ryanmillerwork/juicer/firmware.md

# Firmware build/upload notes

# using github actions:

# automatically compiles on pushes. to make sure the release is stored, tag it:

git tag v3.0.0

git push origin v3.0.0

# to pull the last tagged version

gh release list

gh release download v3.0.0 -p "*.bin"

OR

wget https://github.com/ryanmillerwork/juicer/releases/download/v3.0.0/juice_pump3.ino.bin

# to pull the latest 

gh run list

gh run download RUN_ID --name compiled-binary

compile on hb-server

# get juicer code

cd ~/bin

git clone https://github.com/ryanmillerwork/juicer.git

cd juicer

# if using esp32-s3 reverse tft:

sudo nano ~/.arduino15/packages/esp32/hardware/esp32/3.1.1/variants/adafruit_feather_esp32s3_reversetft/pins_arduino.h

change to "#define USB_PRODUCT "juicer3"

# compile

~/bin/arduino-cli compile --fqbn esp32:esp32:adafruit_feather_esp32s3_reversetft --build-path ~/bin/juicer/juice_pump3/build ~/bin/juicer/juice_pump3/

or

~/bin/arduino-cli compile --fqbn esp32:esp32:adafruit_feather_esp32s2_reversetft_juicer --build-path ~/bin/juicer/juice_pump3/build ~/bin/juicer/juice_pump3

## Troubleshooting build failures

If `arduino-cli compile` fails with:

`Failed to extract libcrypto.so.1.1: decompression resulted in return code -1!`

This is almost always either **(1) disk space / inode exhaustion** (often in `/tmp`) or **(2) a corrupted Arduino cache / staged download**.

1) Check disk space + inodes:

```bash
df -h /tmp ~
df -i /tmp ~
```

2) If space is tight in `/tmp`, point temp elsewhere:

```bash
export TMPDIR="$HOME/tmp"
mkdir -p "$TMPDIR"
```

3) Clear caches and reinstall the ESP32 core/tools:

```bash
rm -rf ~/.arduino15/staging ~/.arduino15/cache
~/bin/arduino-cli core update-index
~/bin/arduino-cli core uninstall esp32:esp32
~/bin/arduino-cli core install esp32:esp32@3.1.1
```

# upload from hb-server to ESP32-s3
```bash
ls /dev/ttyUSB* /dev/ttyACM* 2>/dev/null

~/bin/arduino-cli upload \
  --fqbn esp32:esp32:adafruit_feather_esp32s3_reversetft \
  --port /dev/ttyACM0 \
  --input-dir ~/bin/juicer/juice_pump3/build

or

~/bin/arduino-cli upload   --fqbn esp32:esp32:adafruit_feather_esp32s2_reversetft_juicer   --port /dev/ttyACM0   --input-dir ~/bin/juicer/juice_pump3/build
```

# push back

git add juice_pump3/build/

git commit -m "Add compiled ESP32 firmware build"

git push origin main

# on homebase
# initial setup

cd ~/code

sudo usermod -a -G dialout lab

sudo curl -fsSL https://raw.githubusercontent.com/arduino/arduino-cli/master/install.sh | sh

~/code/bin/arduino-cli core install esp32:esp32

git clone https://github.com/ryanmillerwork/juicer.git

# just to upload code

unplug/replug usb to microcontroller

cd ~/code/juicer/juice_pump3

~/code/bin/arduino-cli board list 

~/code/bin/arduino-cli upload --fqbn esp32:esp32:adafruit_feather_esp32s3_reversetft -p /dev/ttyACM0 --input-dir ./build/ .

sudo systemctl restart dserv

# calibrating

put exactly 500 ml in container

screen /dev/ttyACM0 115200

{"do": {"calibration": {"n": 600, "on": 500, "off": 500}}}

(wait 10 minutes, measure amount of fluid dispensed [f])

if f=200, ml/s = 200/(600*0.5) = 0.67 ml/s

{"set": {"flow_rate": 0.67}}

~3 months after calibration, testing accuracy and precision of 15 individual 1 mL dispersements:

range: 0.94 -- 1.00

mean: 0.97

median: 0.97

STD: 0.02

# setting purge volume

screen /dev/ttyACM0 115200

{"get": ["purge_vol"]}

{"set": {"purge_vol": 20}}
