ryanmillerwork/juicer/20250921_110635.jpg

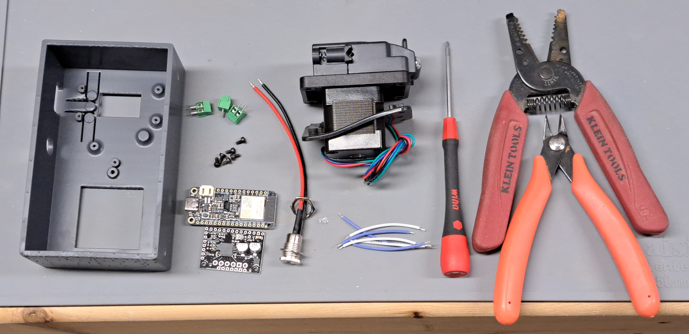
20250921_110635.jpg
