ryanmillerwork/juicer/20250921_114202.jpg

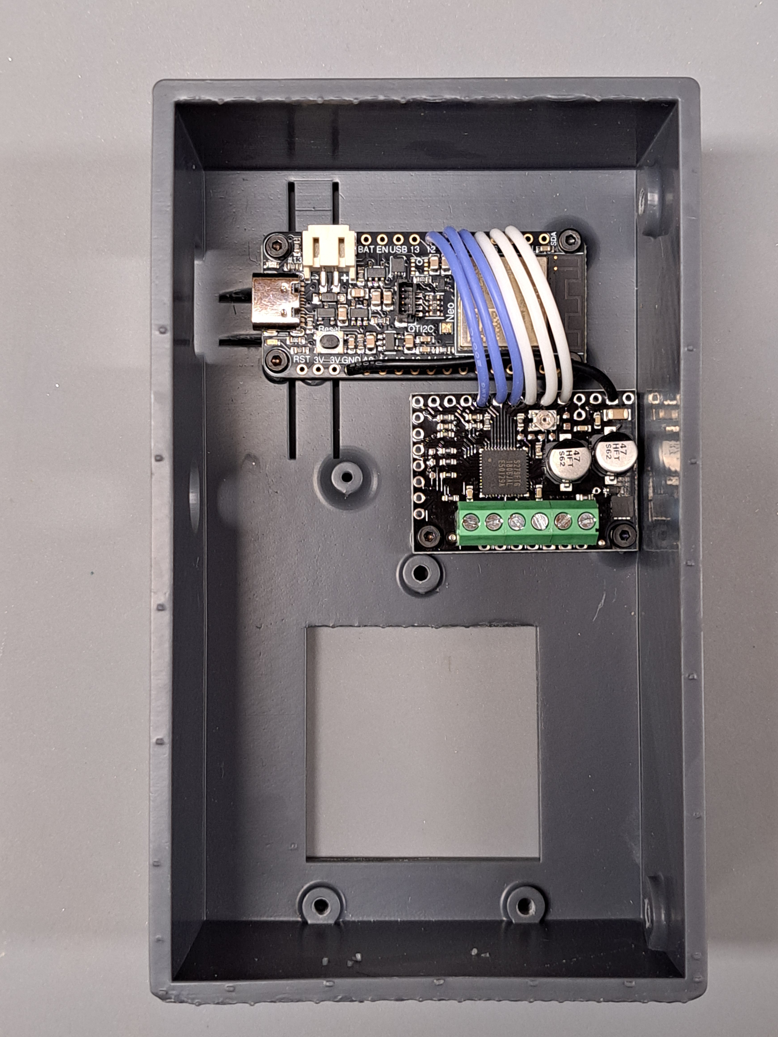
20250921_114202.jpg
