ryanmillerwork/juicer/juice_pump3/juice_pump3.ino

#include <Arduino.h>
#include <driver/ledc.h>
#include <SPI.h>   
#include <Preferences.h>         
#include <Adafruit_GFX.h>         // 1.12.0 by Adafruit
#include <Fonts/FreeMono9pt7b.h>  // from Adafruit_GFX
#include <Adafruit_ST7789.h>      // 1.10.4 by Adafruit
#include <Adafruit_NeoPixel.h>    // 1.12.5 by Adafruit
#include <ArduinoJson.h>          // 7.2.0 by Benoit Blanchon


// Define constants
const int PULSES_PER_STEP = 32;
const int STEPS_PER_REV = 200;
const int MAX_RPS = 8;
const int MAX_PWM_FREQ_MOTOR = PULSES_PER_STEP * STEPS_PER_REV * MAX_RPS;
// Juice level sensor input.
// NOTE: GPIO4 is also the board's built-in I2C SCL pin (STEMMA QT header). If you use it for juice level,
// you should not use the built-in I2C header at the same time.
const int JUICE_LEVEL_LOW_PIN = 4;   // GPIO4 / SCL (LOW = water detected)

float flow_rate;                  // This is the empirically determined flow rate given the target_rps, stored in flash
float purge_vol;                  // Volume to purge when pressing the purge button, stored in flash
int reward_number = 0;            // Number of rewards since being reset
float reward_mls = 0.0;           // Volume of rewards since being reset 
bool purging = false;             // Goes true while purging
bool manual_watering = false;     // Goes true while pressing water button
bool ttl_watering = false;        // Goes true while TTL input line is high
bool serial_watering = false;     // Goes true while watering requested by serial port
bool calibration_in_progress = false;
int calibration_n = 0;
int calibration_on = 0;
int calibration_off = 0;
int calibration_count = 0;
unsigned long calibration_start_time = 0;
float serial_vol = 0.0;           // Keep track of this in case it needs to be subtracted for overlapping rewards
float target_rps;                 // Target rotations per second of the pump head. max is around 3-4
int target_hz;                    // Frequency of pulses to achieve desired target_rps
bool reset_pressed = false;       // Keeps track of button press to only execute on button down
unsigned long water_start_time = 0; // Keeps track of when you first press manual start so we can track amount given
unsigned long ttl_start_time = 0;   // Keeps track of when TTL watering starts so dispensed volume can be calculated on stop
bool pump_running = false;        // Keeps track of if pump is running
uint32_t pump_stop_time = 0;      // What time to stop the pump
bool sched_disp_update = false;   // For when you want to update the display but not quite yet
bool serialConnected = false;
bool notify_reward_complete_pending = false;

// What to do if a serial reward arrives while a serial reward is already in progress.
// - replace: stop/shorten current reward and start requested
// - append: extend current reward by requested amount
// - reject: reject new reward while reward is running
enum RewardOverlapPolicy { ROP_REPLACE = 0, ROP_APPEND = 1, ROP_REJECT = 2 };
RewardOverlapPolicy reward_overlap_policy = ROP_REPLACE;

// Digital juice level monitoring variables
String juice_level = "<50mLs";  // Current juice level status
unsigned long last_juice_check_time = 0;  // For 5-second checks

const int pwmChannel = 0;
const int pwmResolution = 8; // 8-bit resolution
// int stepChannel = -1; // global variable to hold the LEDC channel for the STEP_PIN

const int LEDC_CHANNEL = 0;  // LEDC channel (0-7 for ESP32-S2)
const int LEDC_TIMER_BIT = 8; // 8-bit timer resolution
const int LEDC_BASE_FREQ = 100000; // Base frequency in Hz
const int LEDC_RESOLUTION = 8; // 8-bit resolution
const int stepChannel = 0;  // Use a valid LEDC channel (0-7 for ESP32-S2)
const uint8_t ledcChannel = 0;  // Using channel 0




// Display, NeoPixel, flash setup
Adafruit_ST7789 tft = Adafruit_ST7789(TFT_CS, TFT_DC, TFT_RST);
Adafruit_NeoPixel pixels = Adafruit_NeoPixel(1, PIN_NEOPIXEL, NEO_GRB + NEO_KHZ800);
Preferences preferences;

// test with screen /dev/ttyACM0

/*
 * Available API Commands:
 *
 * 1. Set Commands:
 *    - {"set": {"flow_rate": <float>}}
 *      - Sets the flow rate (must be > 0).
 *    - {"set": {"adjust_flow_rate": {"expected_mls": <float>, "actual_mls": <float>}}}
 *      - Adjusts the stored flow rate using a measured dispense:
 *        - flow_rate_new = flow_rate_old * (actual_mls / expected_mls)
 *        - Returns extra fields: flow_rate_old, flow_rate_new, scale_factor
 *      - NOTE: You must use either set.flow_rate OR set.adjust_flow_rate (not both).
 *    - {"set": {"purge_vol": <float>}}
 *      - Sets the purge volume (must be > 0).
 *    - {"set": {"target_rps": <float>}} {"set": {"target_rps": 3}}
 *      - Sets the target revolutions per second (must be > 0 and <= MAX_RPS).
 *    - {"set": {"direction": "<left|right>"}}  {"set": {"direction": "right"}}
 *      - Persists the pump direction (default is "left", meaning pump from right to left) for all future pump actions.
 *    - {"set": {"reward_overlap_policy": "<replace|append|reject>"}}
 *      - Controls what happens if a reward arrives while a serial reward is already running:
 *        - replace: preempt current and start requested (default)
 *        - append: extend current reward by requested amount
 *        - reject: ignore new reward while reward is running
 *
 * 2. Do Commands (only 1 allowed per request):
 *    - {"do": "abort"}
 *      - Aborts the current operation, stops the pump, and updates reward metrics.
 *    - {"do": "reset"}
 *      - Resets reward counters (number and mLs), same as pressing the reset hardware button.
 *    - {"do": {"reward": <float>}} {"do": {"reward": 0.8}}
 *      - Dispenses a reward of the specified amount (must be > 0).
 *      - If pump is busy (purge/manual/calibration), reward is rejected.
 *      - If a serial reward is running, behavior depends on reward_overlap_policy.
 *    - {"do": {"purge": <float>}}
 *      - Starts a purge operation for the specified amount (must be > 0).
 *    - {"do": {"calibration": {"n": <int>, "on": <int>, "off": <int>}}} {"do": {"calibration": {"n": 10, "on": 500, "off": 500}}}
 *      - Runs a calibration cycle with:
 *        - n: Number of cycles (must be > 0).
 *        - on: Duration in milliseconds for the pump to be ON (must be > 0).
 *        - off: Duration in milliseconds for the pump to be OFF (must be > 0).
 *
 * 3. Get Commands:
 *    - {"get": ["flow_rate"]}
 *      - Retrieves the current flow rate.
 *    - {"get": ["purge_vol"]}
 *      - Retrieves the current purge volume.
 *    - {"get": ["target_rps"]}
 *      - Retrieves the current target revolutions per second.
 *    - {"get": ["reward_mls"]}
 *      - Retrieves the total amount of reward dispensed in milliliters.
 *    - {"get": ["reward_number"]}
 *      - Retrieves the total number of rewards dispensed.
 *    - {"get": ["direction"]}
 *      - Retrieves the persisted pump direction ("left" or "right")
 *    - {"get": ["reward_overlap_policy"]}
 *      - Retrieves the reward overlap policy ("replace", "append", or "reject")
 *    - {"get": ["pump_state"]}
 *      - Retrieves a minimal pump state string: "idle", "purge", "manual", "serial_reward", "ttl", or "calibration"
 *    - {"get": ["juice_level"]}
 *      - Retrieves juice level status string: ">50mLs" or "<50mLs" from the single low-level sensor on GPIO4
 *    - {"get": ["<unknown_parameter>"]}
 *      - Returns "Unknown parameter" for any unrecognized parameter.
 *
 * Example Combined Request:
 *    {"set": {"target_rps": 2, "flow_rate": 0.65}, "do": {"reward": 1},"get": ["reward_mls", "reward_number"]}
 *
 * Expected Response:
 *    {
 *      "status": "success",
 *      "reward_mls": <float>,
 *      "reward_number": <int>
 *    }
 */


// Pin definitions for motor and switches
#define DMODE0_PIN 5
#define DMODE1_PIN 6
#define DMODE2_PIN 9
#define DIR_PIN 10
#define STEP_PIN 11
#define EN_PIN 12

#define SWITCH_D0_PIN 0  // D0 is also used as the BOOT button, pulled HIGH by default
#define SWITCH_D1_PIN 1
#define SWITCH_D2_PIN 2
#define TTL_WATER_PIN 13


enum PumpDirection { DIR_LEFT, DIR_RIGHT };
const PumpDirection DEFAULT_DIRECTION = DIR_LEFT;
PumpDirection current_direction = DEFAULT_DIRECTION;
PumpDirection calibration_direction = DEFAULT_DIRECTION;

String direction_to_string(PumpDirection dir) {
  return dir == DIR_RIGHT ? "right" : "left";
}

String reward_overlap_policy_to_string(RewardOverlapPolicy p) {
  if (p == ROP_APPEND) return "append";
  if (p == ROP_REJECT) return "reject";
  return "replace";
}

// A minimal, single-string representation of what the pump is currently doing.
// Intended for the API `get: ["pump_state"]`.
String pump_state_to_string() {
  if (purging) return "purge";
  if (serial_watering) return "serial_reward";
  if (ttl_watering) return "ttl";
  if (manual_watering) return "manual";
  if (calibration_in_progress) return "calibration";
  return "idle";
}

bool parse_reward_overlap_policy(const String& s, RewardOverlapPolicy& out) {
  String v = s;
  v.toLowerCase();
  if (v == "replace") { out = ROP_REPLACE; return true; }
  if (v == "append") { out = ROP_APPEND; return true; }
  if (v == "reject") { out = ROP_REJECT; return true; }
  return false;
}


void writeTextToScreen(int x, int y, uint16_t color, String text) {
  tft.setCursor(x, y);
  tft.setTextColor(color);
  tft.println(text);
}

void apply_direction(PumpDirection dir) {
  digitalWrite(DIR_PIN, dir == DIR_LEFT ? HIGH : LOW);
}

void update_display(bool highlight_flow = false, bool highlight_purge = false) {
  tft.fillScreen(ST77XX_BLACK);

  if (purging) tft.fillRect(0, 29, 240, 24, 0x0020a8);  // Background rectangle
  if (manual_watering || serial_watering || ttl_watering) tft.fillRect(0, 5, 240, 24, 0x0020a8); // Background rectangle

  writeTextToScreen(10, 20, ST77XX_WHITE, "Flow rate: " + String(flow_rate) + " mL/s");
  writeTextToScreen(10, 44, ST77XX_WHITE, "Purge Vol: " + String(purge_vol) + " mL");
  tft.drawLine(10, 68, 230, 68, ST77XX_WHITE);
  writeTextToScreen(10, 92, ST77XX_WHITE, "Reward #: " + String(reward_number));
  writeTextToScreen(10, 116, ST77XX_WHITE, "Reward mLs: " + String(reward_mls, 3));
}

void start_pump_with_direction(uint32_t color, PumpDirection direction) {
  apply_direction(direction);
  digitalWrite(DMODE0_PIN, HIGH), digitalWrite(DMODE1_PIN, HIGH), digitalWrite(DMODE2_PIN, HIGH);
  // ledcWrite(stepChannel, 128);  // Duty cycle for motor speed
  ledcWrite(STEP_PIN, 128);
  // ledcWrite(stepChannel, 128);  // To start the pump

  pixels.fill(color);
  pixels.show();
  pump_running = true;
}

void start_pump(uint32_t color = pixels.Color(255, 255, 255)) {
  start_pump_with_direction(color, current_direction);
}

void stop_pump() {
  ledcWrite(STEP_PIN, 0);
  // ledcWrite(stepChannel, 0);  // To start the pump

  digitalWrite(DMODE0_PIN, LOW), digitalWrite(DMODE1_PIN, LOW), digitalWrite(DMODE2_PIN, LOW);
  pixels.clear();
  pixels.show();
  pump_running = false;
  apply_direction(current_direction);  // Return to stored direction after any run
}

void reset_counters(bool refresh_display = true) {
  reward_number = 0;
  reward_mls = 0;
  if (refresh_display) update_display();
}

// If a serial reward is currently running, reconcile counters so reward_mls reflects what was actually dispensed so far.
// This allows us to "replace" (preempt) a running reward without over-counting.
void reconcile_running_serial_reward() {
  reward_mls -= serial_vol;
  reward_mls += ((millis() - water_start_time) / 1000.0) * flow_rate;
}

void start_serial_reward(float reward_value, uint32_t color) {
  serial_vol = reward_value;
  serial_watering = true;
  water_start_time = millis();
  start_pump(color);
  pump_stop_time = millis() + reward_value / flow_rate * 1000;
  reward_mls += reward_value;
  reward_number++;
  sched_disp_update = true;
}

void replace_serial_reward(float reward_value, uint32_t color) {
  if (serial_watering) {
    reconcile_running_serial_reward();
  }
  start_serial_reward(reward_value, color);
}

void append_serial_reward(float reward_value) {
  // Extend the existing run. Keep water_start_time unchanged so elapsed time tracks the entire continuous run.
  serial_vol += reward_value;
  uint32_t extra_ms = (uint32_t)(reward_value / flow_rate * 1000.0);
  pump_stop_time += extra_ms;
  reward_mls += reward_value;
  reward_number++;
  sched_disp_update = true;
}

void handle_reward(float reward_value, uint32_t color) {
  if (serial_watering) {
    reconcile_running_serial_reward();
  }
  start_serial_reward(reward_value, color);
}

void handle_calibration(int n, int on, int off) {
  calibration_in_progress = true;
  calibration_n = n;
  calibration_on = on;
  calibration_off = off;
  calibration_count = 0;
  calibration_direction = current_direction;
  calibration_start_time = millis();
  start_pump_with_direction(pixels.Color(0, 255, 0), calibration_direction);
  reward_mls += calibration_on / 1000.0 * flow_rate;
  reward_number++;
  water_start_time = millis();
  update_display();
}

void check_juice_level() {
  // Check juice level every 5 seconds using the single lower sensor
  if (millis() - last_juice_check_time >= 5000) {
    bool low_sensor = (digitalRead(JUICE_LEVEL_LOW_PIN) == LOW);  // LOW = water detected at >50 mL

    juice_level = low_sensor ? ">50mLs" : "<50mLs";

    last_juice_check_time = millis();
  }
}

void check_buttons() {
  // Check for button down for reset
  if (digitalRead(SWITCH_D0_PIN) == LOW && !reset_pressed) {
    reset_pressed = true;
    reset_counters();
  } else if (digitalRead(SWITCH_D0_PIN) == HIGH) {
    reset_pressed = false;  // Reset state when button is released
  }

  // Purge button (S1)
  if (digitalRead(SWITCH_D1_PIN) == HIGH && !purging && !manual_watering && !ttl_watering) {
    purging = true;
    pump_stop_time = millis() + purge_vol / flow_rate * 1000;
    start_pump(pixels.Color(255, 255, 0));
    update_display(false, true); // Highlight purge line
  }

  // Manual water button (S2)
  if (digitalRead(SWITCH_D2_PIN) == HIGH && !purging && !manual_watering && !ttl_watering) {
    manual_watering = true;
    water_start_time = millis();
    start_pump(pixels.Color(255, 0, 255));
    update_display(true, false); // Highlight flow rate line
  }

}

void check_ttl_watering() {
  bool ttl_high = (digitalRead(TTL_WATER_PIN) == HIGH);

  if (ttl_high && !ttl_watering) {
    // Only start TTL watering if nothing else owns the pump.
    if (!purging && !manual_watering && !serial_watering && !calibration_in_progress) {
      ttl_watering = true;
      ttl_start_time = millis();
      reward_number++;
      start_pump(pixels.Color(255, 255, 255));
      update_display(true, false); // Same top-line highlight behavior as serial/manual activity
    }
  } else if (!ttl_high && ttl_watering) {
    reward_mls += ((millis() - ttl_start_time) / 1000.0) * flow_rate;
    ttl_watering = false;
    stop_pump();
    update_display(); // Reset highlight
  }
}

void check_for_pump_stop() {
  if (purging && (millis() >= pump_stop_time)) {
    purging = false;
    stop_pump();
    update_display(); // Reset highlight
  }

  if (serial_watering && (millis() >= pump_stop_time)) {
    // reward_mls += serial_vol;  // Ensure reward_mls is updated correctly
    // reward_number++;
    serial_watering = false;
    stop_pump();
    if (notify_reward_complete_pending) {
      Serial.println("{\"notify\":\"reward_complete\"}");
      notify_reward_complete_pending = false;
    }
    update_display(); // Reset highlight
  }

  if (manual_watering && !digitalRead(SWITCH_D2_PIN)) {
    // Button released, stop manual watering and calculate reward_mls
    reward_mls += ((millis() - water_start_time) / 1000.0) * flow_rate;
    manual_watering = false;
    stop_pump();
    update_display(); // Reset highlight
  }

  if (calibration_in_progress) {
    if (calibration_count < calibration_n) {
      if (pump_running && millis() >= calibration_start_time + calibration_on) {
        stop_pump();
        calibration_start_time = millis();
        update_display(); // Reset highlight
      } else if (!pump_running && millis() >= calibration_start_time + calibration_off) {
        calibration_count++;
        if (calibration_count < calibration_n) {
          start_pump_with_direction(pixels.Color(0, 255, 0), calibration_direction);
          water_start_time = millis();
          reward_mls += calibration_on / 1000.0 * flow_rate;
          reward_number++;
          calibration_start_time = millis();
          update_display(); // Reset highlight
        } else {
          calibration_in_progress = false;
          update_display(); // Reset highlight
        }
      }
    }
  }
}

void check_serial_commands() {
  if (Serial.available() > 0) {
    // Synchronize to the start of a JSON command, discarding any extraneous characters.
    // This helps prevent parsing errors from noise or leftover data in the buffer.
    while (Serial.available() > 0 && Serial.peek() != '{') {
      Serial.read();
    }
    
    // If we didn't find the start of a command, exit and wait.
    if (Serial.available() == 0) {
      return;
    }

    String command = Serial.readStringUntil('\n');
    command.trim();
    StaticJsonDocument<384> doc;
    StaticJsonDocument<400> responseDoc; // Response JSON object to collect status
    DeserializationError error = deserializeJson(doc, command);
    
    if (error) {
      responseDoc["status"] = "failure";
      String errMsg = String(error.c_str());
      if (error == DeserializationError::NoMemory) {
        errMsg += " (JSON too large for buffer)";
      }
      responseDoc["error"] = errMsg;
      String response;
      serializeJson(responseDoc, response);
      Serial.println(response);
      return;
    }

    // Validate that there is at most one "do" operation
    if (doc.containsKey("do")) {
      if (doc["do"].is<JsonObject>()) {
        JsonObject doParams = doc["do"].as<JsonObject>();
        int doCount = 0;
        for (JsonPair keyValue : doParams) {
          doCount++;
        }
        if (doCount > 1) {
          responseDoc["status"] = "failure";
          responseDoc["error"] = "Only one 'do' operation is allowed in the request";
          String response;
          serializeJson(responseDoc, response);
          Serial.println(response);
          return;
        }
      } else if (!doc["do"].is<const char*>()) {
        responseDoc["status"] = "failure";
        responseDoc["error"] = "Invalid 'do' command format";
        String response;
        serializeJson(responseDoc, response);
        Serial.println(response);
        return;
      }
    }

    bool get_notify_requested = false;
    if (doc.containsKey("get")) {
      JsonArray getArray = doc["get"].as<JsonArray>();
      for (JsonVariant value : getArray) {
        if (value.as<String>() == "notify") {
          get_notify_requested = true;
          break;
        }
      }
    }

    if (get_notify_requested) {
      bool reward_in_do = false;
      if (doc.containsKey("do") && doc["do"].is<JsonObject>()) {
        JsonObject doParams = doc["do"].as<JsonObject>();
        reward_in_do = doParams.containsKey("reward");
      }
      if (!reward_in_do) {
        responseDoc["status"] = "failure";
        responseDoc["error"] = "get.notify is only valid when paired with do.reward in the same request";
        String response;
        serializeJson(responseDoc, response);
        Serial.println(response);
        return;
      }
    }

    // Handle "set" operations
    if (doc.containsKey("set")) {
      bool success = true;
      JsonObject setParams = doc["set"].as<JsonObject>();

      // Reject ambiguous requests: don't allow both direct flow_rate and adjust_flow_rate in the same request.
      if (setParams.containsKey("flow_rate") && setParams.containsKey("adjust_flow_rate")) {
        success = false;
        responseDoc["error"] = "Use either set.flow_rate or set.adjust_flow_rate (not both)";
      }

      if (setParams.containsKey("flow_rate")) {
        float new_flow_rate = setParams["flow_rate"].as<float>();
        if (new_flow_rate > 0) {
          flow_rate = new_flow_rate;
          preferences.putFloat("flow_rate", flow_rate);
          sched_disp_update = true;
        } else {
          success = false;
          responseDoc["error"] = "Invalid flow_rate value";
        }
      }

      // Adjust flow_rate based on an expected vs actual dispense measurement.
      // Matches the scaling in `capactive_calibration.py`:
      //   flow_rate_new = flow_rate_old * (actual_mls / expected_mls)
      if (setParams.containsKey("adjust_flow_rate") && success) {
        JsonObject adj = setParams["adjust_flow_rate"].as<JsonObject>();
        float expected_mls = adj["expected_mls"].as<float>();
        float actual_mls = adj["actual_mls"].as<float>();

        if (expected_mls > 0 && actual_mls > 0) {
          float flow_rate_old = flow_rate;
          float scale_factor = actual_mls / expected_mls;
          float flow_rate_new = flow_rate_old * scale_factor;

          flow_rate = flow_rate_new;
          preferences.putFloat("flow_rate", flow_rate);
          sched_disp_update = true;

          responseDoc["flow_rate_old"] = flow_rate_old;
          responseDoc["flow_rate_new"] = flow_rate_new;
          responseDoc["scale_factor"] = scale_factor;
        } else {
          success = false;
          responseDoc["error"] = "Invalid adjust_flow_rate values (expected_mls and actual_mls must be > 0)";
        }
      }
      
      if (setParams.containsKey("purge_vol")) {
        float new_purge_vol = setParams["purge_vol"].as<float>();
        if (new_purge_vol > 0) {
          purge_vol = new_purge_vol;
          preferences.putFloat("purge_vol", purge_vol);
          sched_disp_update = true;
        } else {
          success = false;
          responseDoc["error"] = "Invalid purge_vol value";
        }
      }

      if (setParams.containsKey("target_rps")) {
        float new_target_rps = setParams["target_rps"].as<float>();
        if (new_target_rps > 0 && new_target_rps <= MAX_RPS) {
          target_rps = new_target_rps;
          // Persist motor speed setting across reboots.
          preferences.putFloat("target_rps", target_rps);
          target_hz = min(static_cast<int>(target_rps * PULSES_PER_STEP * STEPS_PER_REV), MAX_PWM_FREQ_MOTOR);
          
          ledcDetach(STEP_PIN);  // Detach the current configuration
          ledcAttachChannel(STEP_PIN, target_hz, pwmResolution, ledcChannel);


          
        } else {
          success = false;
          responseDoc["error"] = "target_rps out of range";
        }
        sched_disp_update = true;
      }

      if (setParams.containsKey("direction")) {
        const char* dirValue = setParams["direction"];
        if (dirValue != nullptr) {
          String dirString = String(dirValue);
          dirString.toLowerCase();
          if (dirString == "right") {
            current_direction = DIR_RIGHT;
            calibration_direction = current_direction;
            preferences.putInt("direction", static_cast<int>(current_direction));
          } else if (dirString == "left") {
            current_direction = DIR_LEFT;
            calibration_direction = current_direction;
            preferences.putInt("direction", static_cast<int>(current_direction));
          } else {
            success = false;
            responseDoc["error"] = "Invalid direction value (use left or right)";
          }
        } else {
          success = false;
          responseDoc["error"] = "Invalid direction value (use left or right)";
        }
      }

      if (setParams.containsKey("reward_overlap_policy")) {
        const char* polValue = setParams["reward_overlap_policy"];
        if (polValue != nullptr) {
          RewardOverlapPolicy new_policy;
          if (parse_reward_overlap_policy(String(polValue), new_policy)) {
            reward_overlap_policy = new_policy;
            preferences.putInt("reward_overlap_policy", static_cast<int>(reward_overlap_policy));
          } else {
            success = false;
            responseDoc["error"] = "Invalid reward_overlap_policy (use replace, append, or reject)";
          }
        } else {
          success = false;
          responseDoc["error"] = "Invalid reward_overlap_policy (use replace, append, or reject)";
        }
      }

      responseDoc["status"] = success ? "success" : "failure";
    }

    // Handle "do" operations
    if (doc.containsKey("do")) {
      bool success = true;

      // Check if "do" is a simple string command (e.g., {"do": "abort"})
      if (doc["do"].is<const char*>()) {
        String action = doc["do"].as<String>();
        if (action == "abort") {
          stop_pump();
          if (serial_watering || ttl_watering || calibration_in_progress) {
            if (serial_watering) {
              reward_mls -= serial_vol;
              reward_mls += ((millis() - water_start_time) / 1000.0) * flow_rate;
            }
            if (ttl_watering) {
              reward_mls += ((millis() - ttl_start_time) / 1000.0) * flow_rate;
            }
            if (calibration_in_progress) {
              reward_mls -= calibration_on / 1000.0 * flow_rate;
              reward_mls += ((millis() - water_start_time) / 1000.0) * flow_rate;
            }
            serial_watering = false;
            ttl_watering = false;
            calibration_in_progress = false;
          }
          notify_reward_complete_pending = false;
          sched_disp_update = true;
        } else if (action == "reset") {
          reset_counters(false);
          sched_disp_update = true;
        } else {
          success = false;
          responseDoc["error"] = "Unknown action";
        }
      }
      // Handle "do" with parameters (e.g., {"do": {"reward": 5}})
      else if (doc["do"].is<JsonObject>()) {
        JsonObject doParams = doc["do"].as<JsonObject>();
        bool validCommand = false;

        if (doParams.containsKey("reward")) {
          validCommand = true;
          float reward_value = doParams["reward"].as<float>();
          if (reward_value > 0) {
            // Reject reward if pump is busy in a mode we don't want to interrupt.
            if (purging) {
              success = false;
              responseDoc["error"] = "Busy: purge in progress (reward rejected)";
            } else if (manual_watering) {
              success = false;
              responseDoc["error"] = "Busy: manual watering in progress (reward rejected)";
            } else if (ttl_watering) {
              success = false;
              responseDoc["error"] = "Busy: ttl watering in progress (reward rejected)";
            } else if (calibration_in_progress) {
              success = false;
              responseDoc["error"] = "Busy: calibration in progress (reward rejected)";
            } else if (serial_watering) {
              // Serial reward overlap handling
              if (reward_overlap_policy == ROP_REJECT) {
                success = false;
                responseDoc["error"] = "Ignored: reward already in progress (policy=reject)";
              } else if (reward_overlap_policy == ROP_APPEND) {
                // If we've already passed the stop time but haven't processed it yet, treat as idle.
                if ((int32_t)(pump_stop_time - millis()) <= 0) {
                  serial_watering = false;
                  stop_pump();
                  start_serial_reward(reward_value, pixels.Color(255, 255, 255));
                } else {
                  append_serial_reward(reward_value);
                }
              } else {
                // Default: replace
                replace_serial_reward(reward_value, pixels.Color(255, 255, 255));
              }
            } else {
              // Normal, idle case
              start_serial_reward(reward_value, pixels.Color(255, 255, 255));
            }
            if (success && get_notify_requested) {
              notify_reward_complete_pending = true;
            }
          } else {
            success = false;
            responseDoc["error"] = "Invalid reward value";
          }
        }

        if (doParams.containsKey("purge")) {
          validCommand = true;
          float purge_amount = doParams["purge"].as<float>();
          if (purge_amount > 0) {
            purging = true;
            pump_stop_time = millis() + purge_amount / flow_rate * 1000;
            start_pump(pixels.Color(255, 255, 0));
            sched_disp_update = true;
          } else {
            success = false;
            responseDoc["error"] = "Invalid purge amount";
          }
        }

        if (doParams.containsKey("calibration")) {
          validCommand = true;
          JsonObject calibrationParams = doParams["calibration"].as<JsonObject>();
          int n = calibrationParams["n"].as<int>();
          int on = calibrationParams["on"].as<int>();
          int off = calibrationParams["off"].as<int>();

          if (n > 0 && on > 0 && off > 0) {
            handle_calibration(n, on, off);
          } else {
            success = false;
            responseDoc["error"] = "Invalid calibration parameters.";
          }
        }

        if (!validCommand) {
          success = false;
          responseDoc["error"] = "Invalid 'do' command format. Use 'abort' as a string, or valid parameters.";
        }
      }

      responseDoc["status"] = success ? "success" : "failure";
    }

    // Handle "get" operations
    if (doc.containsKey("get")) {
      JsonArray getArray = doc["get"].as<JsonArray>();

      for (JsonVariant value : getArray) {
        String param = value.as<String>();

        if (param == "flow_rate") responseDoc["flow_rate"] = flow_rate;
        else if (param == "purge_vol") responseDoc["purge_vol"] = purge_vol;
        else if (param == "target_rps") responseDoc["target_rps"] = target_rps;
        else if (param == "reward_mls") responseDoc["reward_mls"] = reward_mls;
        else if (param == "reward_number") responseDoc["reward_number"] = reward_number;
        else if (param == "direction") responseDoc["direction"] = direction_to_string(current_direction);
        else if (param == "reward_overlap_policy") responseDoc["reward_overlap_policy"] = reward_overlap_policy_to_string(reward_overlap_policy);
        else if (param == "pump_state") responseDoc["pump_state"] = pump_state_to_string();
        else if (param == "juice_level") responseDoc["juice_level"] = juice_level;
        else if (param == "notify") { /* handled asynchronously */ }
        else responseDoc[param] = "Unknown parameter";
      }
    }

    // Send the response JSON
    String response;
    serializeJson(responseDoc, response);
    Serial.println(response);
    Serial.flush(); // intended to speed up the response

    if (sched_disp_update) {
      update_display();
      sched_disp_update = false;
    }
  }
}


void check_serial_connection() {
  if (Serial && !serialConnected) {
    serialConnected = true;
    // Serial.println("Serial connected!");
  }

  if (!Serial && serialConnected) {
    serialConnected = false;
    // Serial.println("Serial disconnected. Restarting serial...");
    Serial.end();
    delay(1000); // Let the USB stack settle
    Serial.begin(2000000);
  }
}


void setup() {

  Serial.begin(2000000);
  Serial.setRxBufferSize(128);  // intended to speed things up. make sure its not too small...  Set RX buffer to 128 bytes for 128 characters max, assuming UTF-8

  // Setup preferences
  preferences.begin("watering", false); // open the watering namespace in read-write mode
  flow_rate = preferences.getFloat("flow_rate", 0.5);
  purge_vol = preferences.getFloat("purge_vol", 10.0);
  target_rps = preferences.getFloat("target_rps", 4.0);
  target_hz = min(static_cast<int>(target_rps * PULSES_PER_STEP * STEPS_PER_REV), MAX_PWM_FREQ_MOTOR);
  int stored_direction = preferences.getInt("direction", static_cast<int>(DEFAULT_DIRECTION));
  current_direction = (stored_direction == static_cast<int>(DIR_RIGHT)) ? DIR_RIGHT : DIR_LEFT;
  calibration_direction = current_direction;
  reward_overlap_policy = static_cast<RewardOverlapPolicy>(preferences.getInt("reward_overlap_policy", static_cast<int>(ROP_REPLACE)));

  // Setup backlight and power
  pinMode(TFT_BACKLITE, OUTPUT);
  digitalWrite(TFT_BACKLITE, HIGH);
  pinMode(TFT_I2C_POWER, OUTPUT);
  digitalWrite(TFT_I2C_POWER, HIGH);
  delay(10);

  // Initialize display
  tft.init(135, 240);
  tft.setRotation(1);
  tft.fillScreen(ST77XX_BLACK);
  tft.setFont(&FreeMono9pt7b);
  tft.setTextWrap(false);
  update_display(false, false);

  // Set up motor control pins
  pinMode(EN_PIN, OUTPUT);
  pinMode(DMODE0_PIN, OUTPUT);
  pinMode(DMODE1_PIN, OUTPUT);
  pinMode(DMODE2_PIN, OUTPUT);
  pinMode(STEP_PIN, OUTPUT);
  pinMode(DIR_PIN, OUTPUT);
  // Setup juice level sensor pin (digital input).
  // No internal pull-up (some sensors can't sink enough current, resulting in ~2-3V "low").
  // If the line floats, add an external pull-up/down appropriate for your sensor output type.
  pinMode(JUICE_LEVEL_LOW_PIN, INPUT);
  pinMode(SWITCH_D0_PIN, INPUT_PULLUP); // D0 is pulled HIGH by default
  pinMode(SWITCH_D1_PIN, INPUT_PULLDOWN);
  pinMode(SWITCH_D2_PIN, INPUT_PULLDOWN);
  pinMode(TTL_WATER_PIN, INPUT_PULLDOWN);

  digitalWrite(EN_PIN, HIGH);
  digitalWrite(DMODE0_PIN, LOW);
  digitalWrite(DMODE1_PIN, LOW);
  digitalWrite(DMODE2_PIN, LOW);
  apply_direction(current_direction);

  // Set the pin mode and ensure the pin is LOW initially
  pinMode(STEP_PIN, OUTPUT);
  digitalWrite(STEP_PIN, LOW);

  // Attach the pin to LEDC using an explicit channel
  ledcAttachChannel(STEP_PIN, target_hz, pwmResolution, ledcChannel);
  delay(10);

  // Initialize NeoPixel
  pixels.begin();
  pixels.setBrightness(75);
  pixels.show();

  // initialize timers to current time
  last_juice_check_time = millis();
}

void loop() {
  check_serial_connection();
  check_juice_level();
  check_buttons();
  check_ttl_watering();
  check_serial_commands();
  check_for_pump_stop();
}
