ryanmillerwork/juicer/(commit log)

2025-04-15 Add compiled ESP32 firmware build
    [partitions.csv]
2025-04-15 Update juice_pump3.inao added charging detection
2025-04-15 compiled with new charging check
2025-04-15 Update juice_pump3.ino
    changed from 1 to 5 minutes for measuring charging
2025-04-16 Update arduino-ci.yml
    adding saving options
2025-08-21 removed serial prints that arent responses to requests
2025-09-21 assembly pics
2025-09-21 Delete 20250412_131200.jpg
    old style with voltage monitor
2025-11-18 change water monitoring to capacitive
2025-11-19 reading 3 analog touch sensor pins, but only if the pump isnt running
2025-11-21 added reset_counters to api
    [juice_pump3.ino, load_water_csv.py]
2025-11-21 Update README.md
    add instructions for esp32-s2
2025-11-21 adding ability to run pump backwards
2025-12-10 made pump direction persistent and remove voltage monitoring logic
2025-12-12 changed juice level low pin to be the stemma qt SCL pin
2025-12-15 using firmware calibration adjustment
2025-12-17 adding assembly instructions
2026-03-04 fix for long JSON and existing arduino files
    [juice_pump3.ino, unit_test.py, update_juicer_firmware.py]
