ryanmillerwork/juicer/20250921_115739.jpg

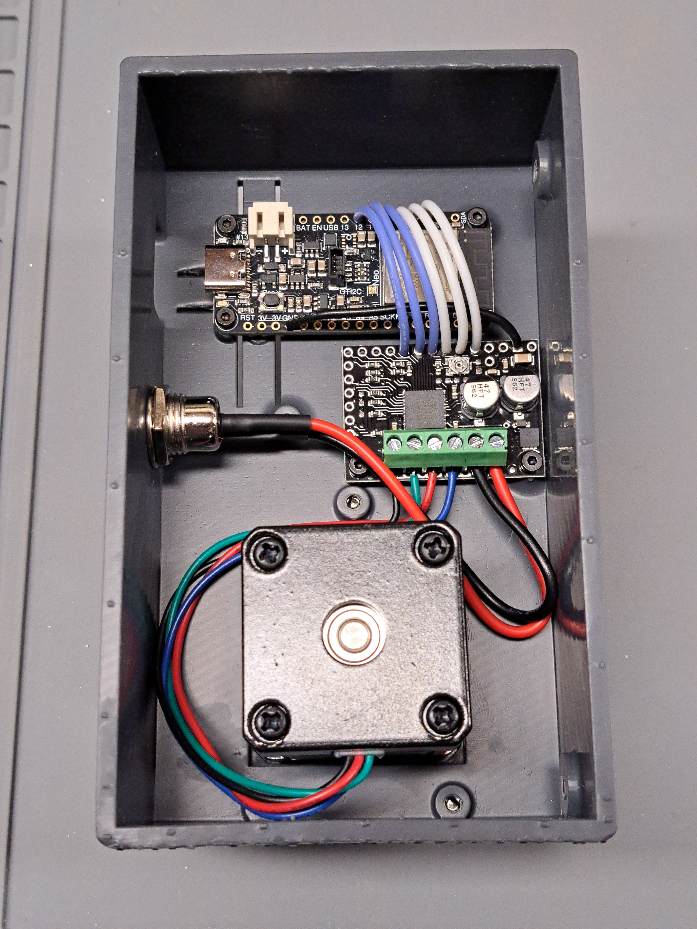
20250921_115739.jpg
